nesl/citysniff/sensorboard/Urban_Node/PCB_Project1_liste_finale.xls

Designator | Footprint | LibRef | Value |  | TMOTE SKY
C1 | CC1608-0603 | Cap Semi | 4.7uF | 5V
C2 | CC1608-0603 | Cap Semi | 1uF | 16V
C3 | CC1608-0603 | Cap Semi | 2.2uF | 5V
C4 | CC1608-0603 | Cap Semi | 2.2uF | 5V
C5 | CC3216-1206 | Cap Semi | 4.7uF | 16V
C6 | CC1608-0603 | Cap Semi | 0.1uF | 5V
C11 | CC3216-1206 | Cap Semi | 10uF | 5V
C13 | CC1608-0603 | Cap Semi | 1uF | 5V
C14 | CC1608-0603 | Cap Semi | 4.7pF | 5V
C17 | Case size D (Epcos) | Cap Semi | 100uF | 5V !! tantal polarise!!
C30 | CC3216-1206 | Cap Pol3 | 10uF | 5V
C31 | CC1608-0603 | Cap Semi | 100nF | 5V
C32 | CC3216-1206 | Cap Pol3 | 10uF | 5V
C33 | CC1608-0603 | Cap Semi | 100nF | 5V
C34 | CC1608-0603 | Cap Semi | 100nF | 5V
C35 | CC3216-1206 | Cap Pol3 | 10uF | 5V
C36 | CC3216-1206 | Cap Pol3 | 10uF | 5V
C37 | CC1608-0603 | Cap Semi | 100pF | 5V
C38a | CC1608-0603 | Cap Semi | 100pF | 5V
C38b | CC1608-0603 | Cap Semi | 100pF | 5V
C39 | CC1608-0603 | Cap Semi | 33pF | 5V
C50 | CC1608-0603 | Cap Semi | 33pF | 5V
C51 | CC1608-0603 | Cap Semi | 100nF | 5V
C60 | CC1608-0603 | Cap Semi | 33pF | 5V
C63 | CC1608-0603 | Cap Semi | 100nF | 5V
C70 | CC1608-0603 | Cap Semi | 33pF | 5V
C71 | CC1608-0603 | Cap Semi | 100nF | 5V
C80 | CC1608-0603 | Cap Semi | 33pF | 5V
C81 | CC1608-0603 | Cap Semi | 100nF | 5V
C100 | CC1608-0603 | Cap Semi | 33pF | 5V
C101 | CC1608-0603 | Cap Semi | 100nF | 5V
D1 | SOD123/X.85 | D Schottky |  | Farnel708136
D2 | SOD123/X.85 | D Schottky |  | Farnel708136
D3 | sot663 | D Zener |  | Farnell8735328
D4 | sot663 | D Zener |  | Farnell8735328
D11 | SOD-123 | D Schottky |  | Farnel708136
DS1 | CR1608-0603 | LED3 | bleu
DS2 | CR1608-0603 | LED3 | rouge
DS3 | CR1608-0603 | LED3 | vert
J1 | Alimetation externe | PWR | RASM722 | Distrelec115104
JP2 | HDR2X3 | Header 3X2 | femelle 90degré | Distrelec121601 | Distrelec128407
JP3 | HDR2X5 | Header 5X2 | femelle 90degré | Distrelec121601 | Distrelec128407
JP4 | HDR1X3 | Header 3X2 |  | Distrelec122214
JP9 | HDR2X3 | Header 3X2 |  | Distrelec128407
L11 | CC3225-1210 | Inductor | 10uH | Farnell9522042
L12 | CC3225-1210 | Inductor | 10uH | Farnell9522042
P1 | Clips de pile - K92 | Plug | K92 | Distrelec970182
P2 | Clips de pile - K92 | Plug | K92 | Distrelec970182
Q1 | SOT-23 | PMOS-2 | FDN340P | F3544977
Q2 | SOT-23 | PMOS-2 | FDN340P | F3544977
Q3 | SOT-23 | PMOS-2 | FDN340P | F3544977
R2 | C1608-0603 | Res3 | 1K | tol. 1%
R3 | C1608-0603 | Res3 | 10K | tol. 1%
R4 | C1608-0603 | Res3 | 10K | tol. 1%
R5 | C1608-0603 | Res3 | 100K | tol. 1%
R6 | C1608-0603 | Res3 | 100K | tol. 1%
R7 | C1608-0603 | Res3 | 220 | tol. 1%
R11 | C1608-0603 | Res3 | 1M | tol. 1%
R12 | C1608-0603 | Res3 | 1M | tol. 1%
R20 | C1608-0603 | Res3 | 56K | tol. 1%
R21 | C1608-0603 | Res3 | 200K | tol. 1%
R22 | C1608-0603 | Res3 | 100K | tol. 1%
R23 | C1608-0603 | Res3 | 100K | tol. 1%
R24 | C1608-0603 | Res3 | 100K | tol. 1%
R30 | C1608-0603 | Res3 | 2.2K | tol. 1%
R31 | C1608-0603 | Res3 | 2.2K | tol. 1%
R32 | C1608-0603 | Res3 | 0K | tol. 1%
R33 | C1608-0603 | Res3 | 0K | tol. 1%
R34 | C1608-0603 | Res3 | 100K | tol. 1%
R35 | C1608-0603 | Res3 | 100K | tol. 1%
R36 | C1608-0603 | Res3 | 120K | tol. 1%
R37 | C1608-0603 | Res3 | 120K | tol. 1%
R38 | C1608-0603 | Res3 | 100K | tol. 1%
R60 | C1608-0603 | Res3 | 2k | tol. 1%
R90 | C1608-0603 | Res3 | 500k | tol. 1%
R91 | C1608-0603 | Res3 | 500k | tol. 1%
R112 | C1608-0603 | Res3 | 10k | tol. 1%
R121 | C1608-0603 | Res3 | 1.5M | tol. 1%
R130 | C1608-0603 | Res3 | 220 | tol. 1%
R131 | C1608-0603 | Res3 | 220 | tol. 1%
R132 | C1608-0603 | Res3 | 220 | tol. 1%
R133 | C1608-0603 | Res3 | 220 | tol. 1%
RT1 | R2012-0805 | Res Thermal |  | Distrelec730728
Rtest | CR5025-2010 | Res3 | 0.1
U1 | 17 Thin QFN 5mmx5mm | MAX1874 | MAXIM
U4 | RM-10 | SSM2167_1 | Analog device
U5 | SO-8 | TS921 | Ampli Rail-to-rail
U6 | SO-8 | TS921
U7 | SO-8 | TS921
U8 | SO-8 | TS921
U11 | SOT23-5 | LT1615/LT1615-1 | Linear technology
U20 | Adg704micro | ADG884 | Analog device
U21 | SOT23-5 | ZXCT1010 | Zetex
