nesl/citysniff/sensorboard/Assembly Drawings.pdf

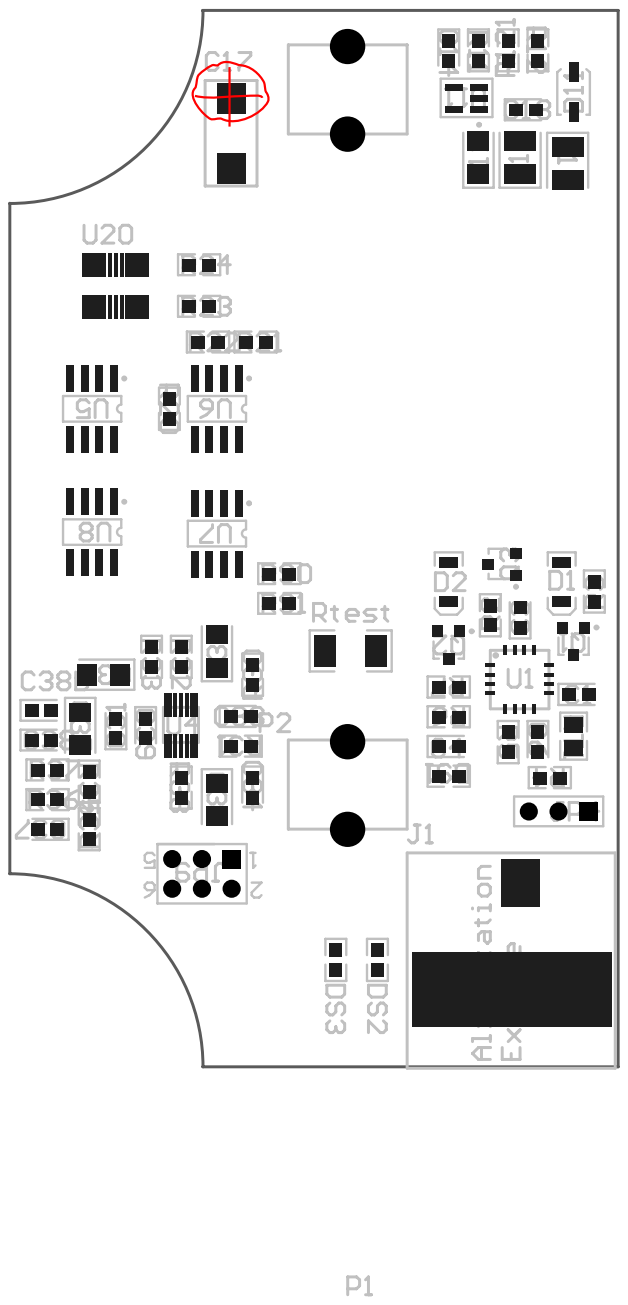
[picture p52: page 1]

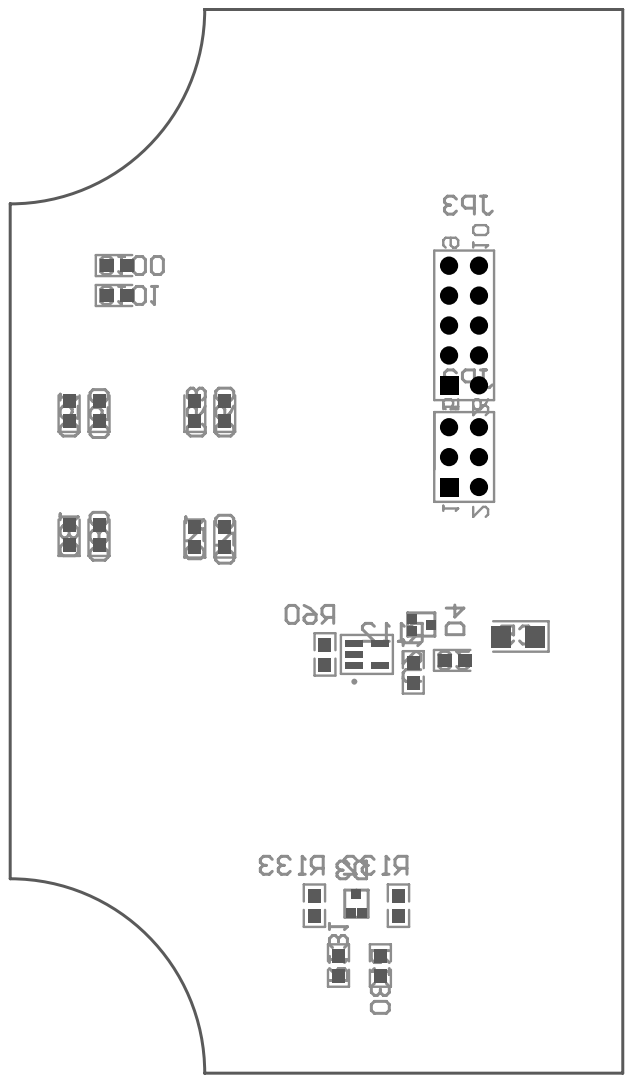
[picture p53: page 2]
