nesl/citysniff/sensorboard/Urban_Node/Schematic Prints.pdf

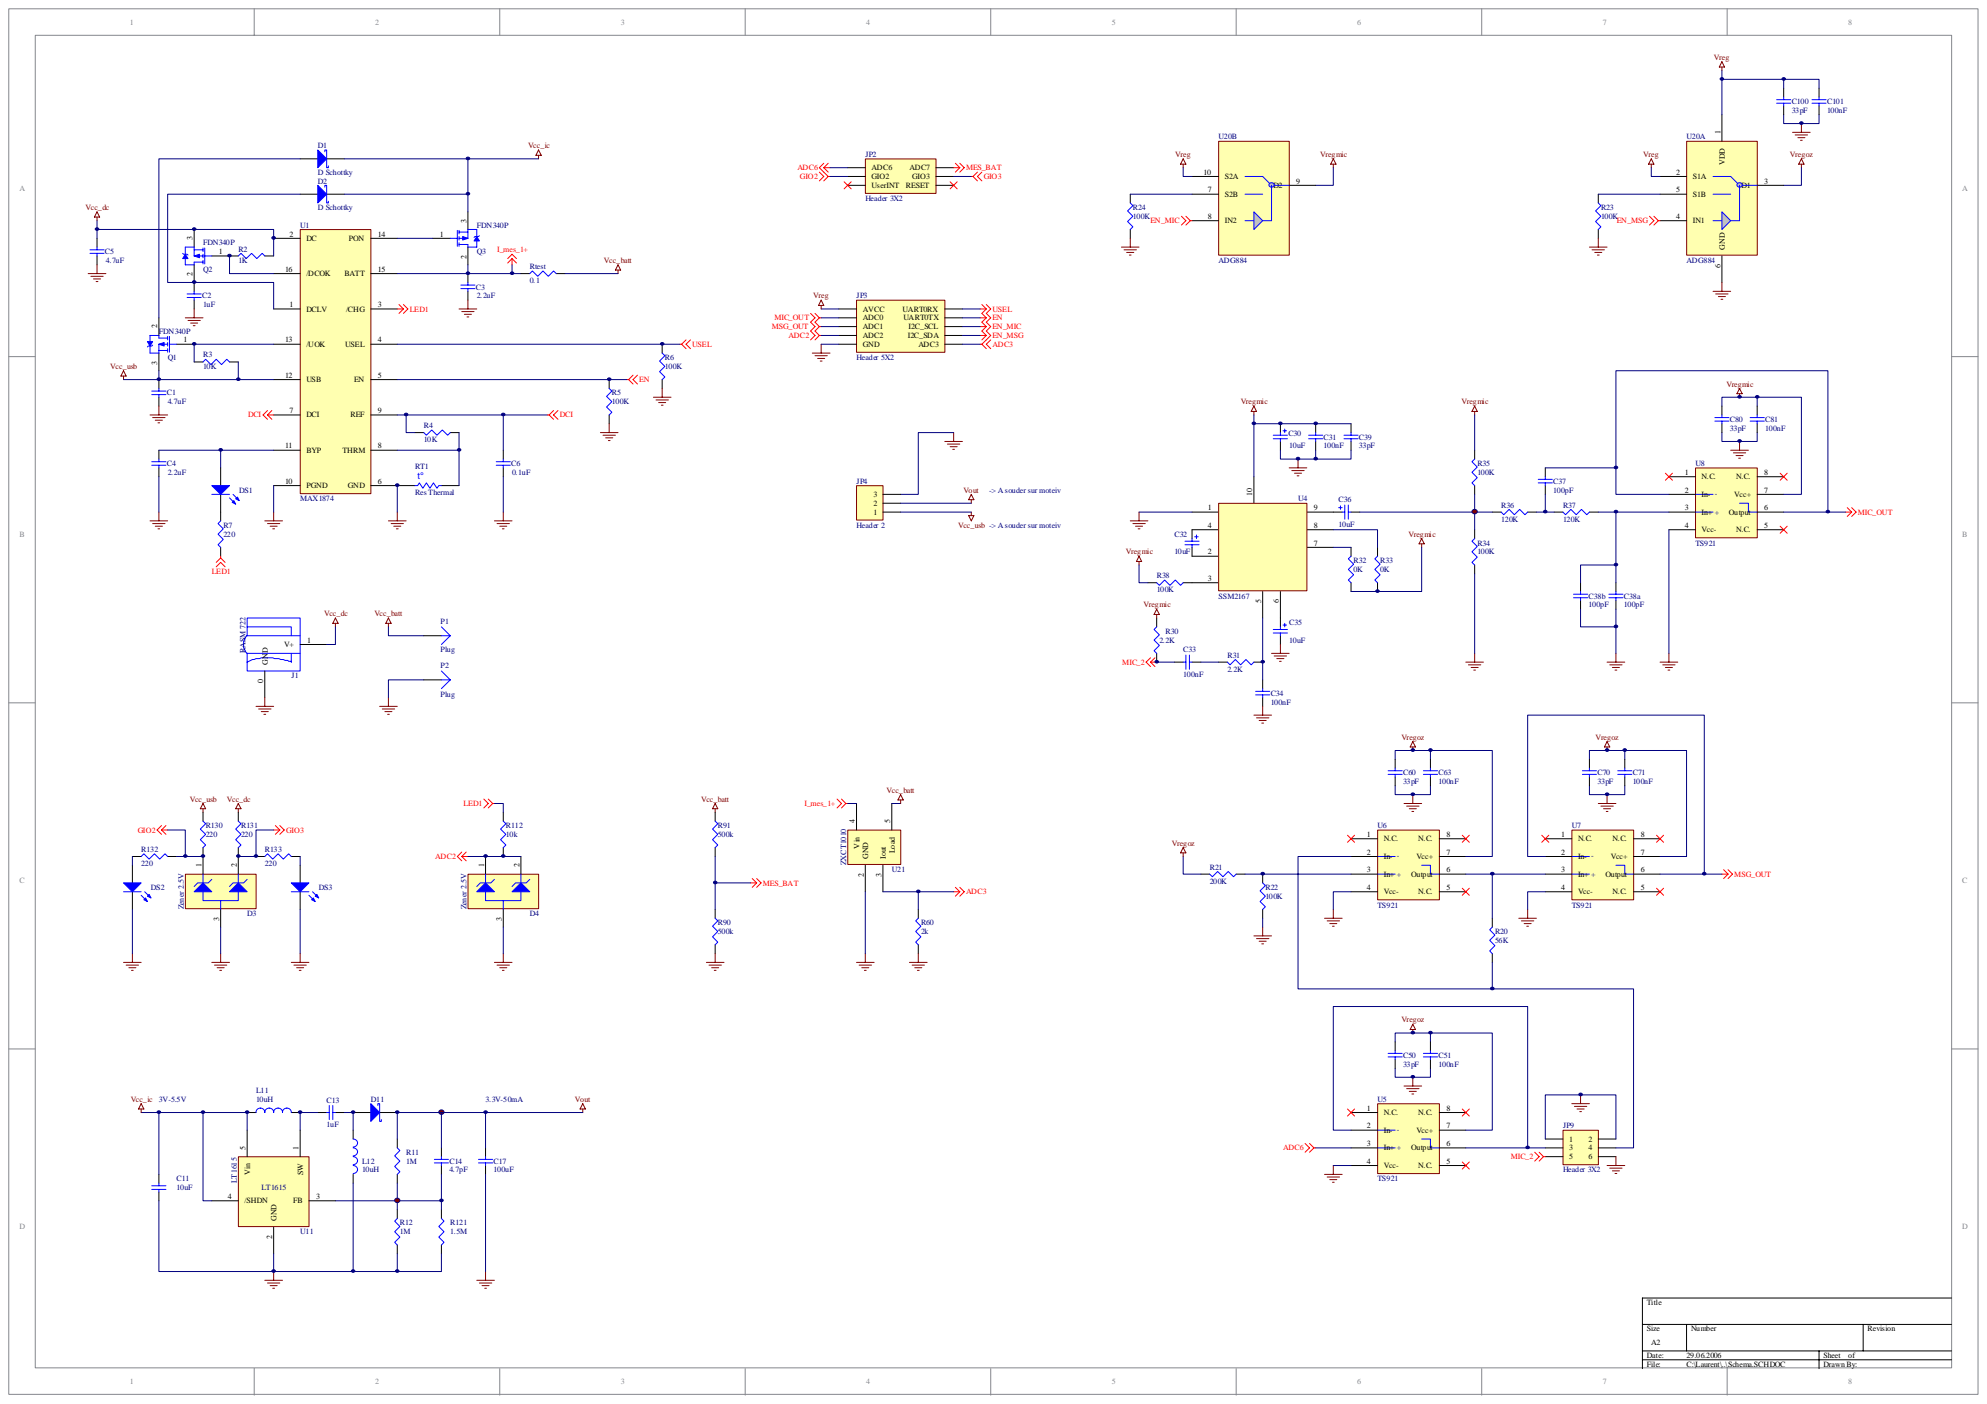
[picture p54: page 1]

D1 | Vcc_ic Vcc_batt | JP2 Vreg | U20B USEL EN EN_MIC EN_MSG ADC3 | | Vreg

Title

Size A2 | Number | | Revision

Date: 29.06.2006 | | Sheet of
File: C:\Laurent\..\Schema.SCHDOC | | Drawn By:
