nesl/citysniff/sensorboard/Composite Drawing top.pdf

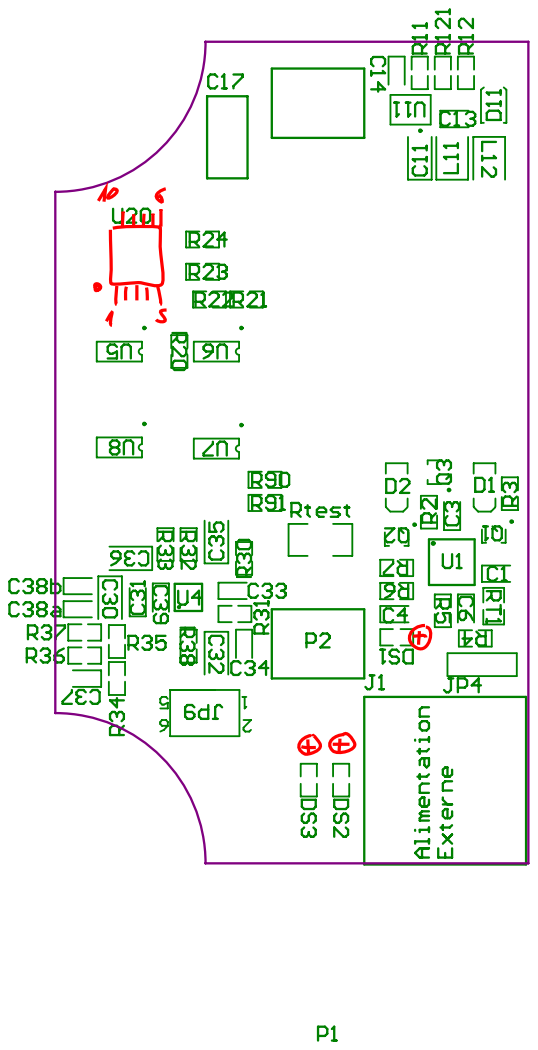
[picture p55: page 1]
