nesl/citysniff/sensorboard/Urban_Node/Composite Drawing.pdf

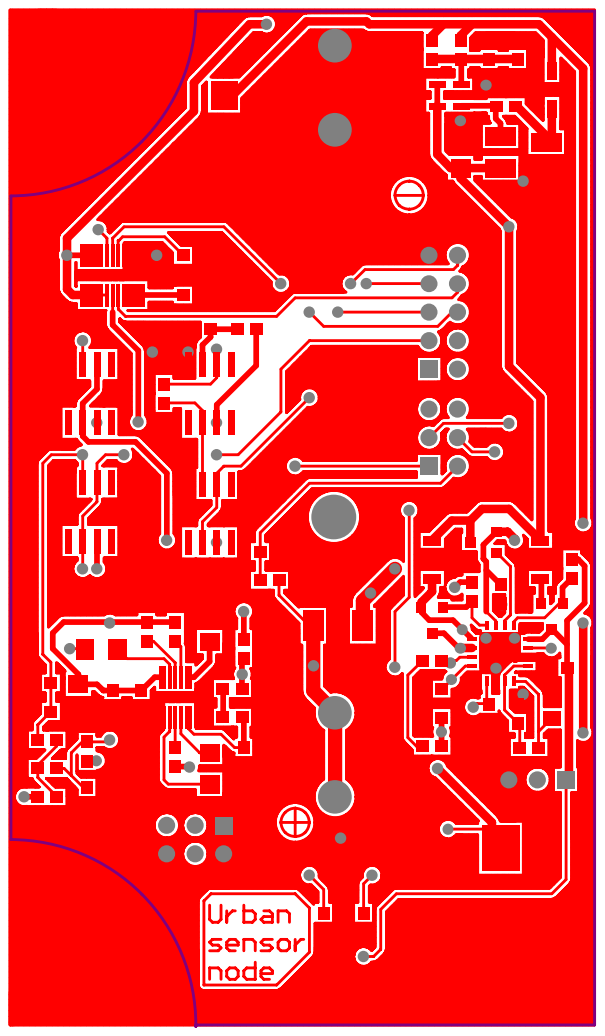
[picture p56: page 1]
