nesl/citysniff/(commit log)

2007-02-02 drawings and schematics of sensor node
    [PCB2.DRL, PCB2.GBL, PCB2.GBO, PCB2.GBP, PCB2.GBS, PCB2.GKO, PCB2.GM1, PCB2.GTL]
2007-07-10 added first version of citysniff sensor board mic driver.
2007-07-10 After changing R20 on the hardware, the ozone meter now works.
    For more details on the hardware modifications, see sensorboard.Errata.txt
    [citysniff.h, mic.c, ozone.c, sampler.c]
